abalmos/isoblue-wifi/hardware/udoo-power/udoo-power_bom_.html

Source File | /home/abalmos/isoblue-3/hardware/udoo-power/udoo-power.sch
BoM Date | Mon 23 Sep 2019 11:00:21 AM EDT
Schematic Version
Schematic Date
PCB Variant | default
KiCad Version | Eeschema (5.99.0-111-gae79a2bdc)
Component Groups | 60
Component Count (per PCB) | 81
Fitted Components (per PCB) | 81
Number of PCBs | 1
Total Component Count (for 1 PCBs) | 81
 | Description | Part | References | Value | Footprint | Quantity Per PCB | Datasheet | PartNum | DigiKey | Voltage | Color | DigiKey2 | Datasheet2 | PartNum2 | DNP | Tol | Power
1 | Unpolarized capacitor, small symbol | C_Small | C1 C2 C4 C6 C7 C8 C9 | 0.1uF | C_0603_1608Metric_Pad1.05x0.95mm_HandSolder | 7 | http://www.samsungsem.com/kr/support/product-search/mlcc/CL10B104KB8NNNL.jsp | CL10B104KB8NNNL | 1276-CL10B104KB8NNNLCT-ND | 50V
2 | Unpolarized capacitor, small symbol | C_Small | C10 | 10nF | C_0603_1608Metric_Pad1.05x0.95mm_HandSolder | 1 | http://www.samsungsem.com/kr/support/product-search/mlcc/CL10B103KB8NNNC.jsp | CL10B103KB8NNNC | 1276-1009-1-ND | 50V
3 | Unpolarized capacitor, small symbol | C_Small | C3 | 10uF | C_0603_1608Metric_Pad1.05x0.95mm_HandSolder | 1 | http://www.samsungsem.com/kr/support/product-search/mlcc/CL10A106MQ8NNNC.jsp | CL10A106MQ8NNNC | 1276-1119-1-ND
4 | Unpolarized capacitor, small symbol | C_Small | C5 C12 | 1uF | C_0603_1608Metric_Pad1.05x0.95mm_HandSolder | 2 | https://media.digikey.com/pdf/Data%20Sheets/Samsung%20PDFs/CL10B105MO8NNWC.pdf | CL10B105MO8NNWC CL10A105KB8NNNC | 1276-6524-1-ND 1276-1860-1-ND | 50V
5 | Unpolarized capacitor, small symbol | C_Small | C15 | 2.2u | C_0603_1608Metric_Pad1.05x0.95mm_HandSolder | 1 | http://www.samsungsem.com/kr/support/product-search/mlcc/CL10B225KQ8NFNC.jsp | CL10B225KQ8NFNC | 1276-2017-1-ND
6 | Unpolarized capacitor, small symbol | C_Small | C11 | 220uF | CP_Radial_D10.0mm_P5.00mm | 1 | https://industrial.panasonic.com/cdbs/www-data/pdf/RDF0000/ABA0000C1018.pdf | EEU-FM1H221 | P12397-ND | 50V
7 | Unpolarized capacitor, small symbol | C_Small | C13 C14 C16 | 22uF | C_1812_4532Metric_Pad1.30x3.40mm_HandSolder | 3 | https://product.tdk.com/info/en/catalog/datasheets/mlcc_commercial_general_en.pdf | C4532X7R1E226M250KC | 445-1607-1-ND
8 | Zener diode, small symbol, filled shape | D_Zener_Small_ALT | D10 | 18V | D_SOD-123 | 1 | https://www.taiwansemi.com/products/datasheet/BZT52B2V4%20series_F15.pdf | BZT52B18 | BZT52B18RHGCT-ND
9 | Light emitting diode, small symbol, filled shape | LED_Small_ALT | D1 | ACT. | LED_0805_2012Metric_Pad1.15x1.40mm_HandSolder | 1 | https://katalog.we-online.de/led/datasheet/150080BS75000.pdf | 150080BS75000 | 732-4982-1-ND |  | blue
10 | Light emitting diode, small symbol, filled shape | LED_Small_ALT | D2 | CELL | LED_0805_2012Metric_Pad1.15x1.40mm_HandSolder | 1 | https://katalog.we-online.de/led/datasheet/150080BS75000.pdf | 150080BS75000 | 732-4982-1-ND |  | blue
11 | Light emitting diode, small symbol, filled shape | LED_Small_ALT | D4 | GPS | LED_0805_2012Metric_Pad1.15x1.40mm_HandSolder | 1 | https://katalog.we-online.de/led/datasheet/150080BS75000.pdf | 150080BS75000 | 732-4982-1-ND |  | blue
12 | Light emitting diode, small symbol, filled shape | LED_Small_ALT | D5 | LED1 | LED_0805_2012Metric_Pad1.15x1.40mm_HandSolder | 1 | https://katalog.we-online.de/led/datasheet/150080YS75000.pdf | 150080YS75000 | 732-4987-1-ND |  | yellow
13 | Light emitting diode, small symbol, filled shape | LED_Small_ALT | D6 | LED2 | LED_0805_2012Metric_Pad1.15x1.40mm_HandSolder | 1 | https://katalog.we-online.de/led/datasheet/150080YS75000.pdf | 150080YS75000 | 732-4987-1-ND |  | yellow
14 | Light emitting diode, small symbol, filled shape | LED_Small_ALT | D14 | LED3 | LED_0805_2012Metric_Pad1.15x1.40mm_HandSolder | 1 | https://katalog.we-online.de/led/datasheet/150080RS75000.pdf | 150080RS75000 | 732-4984-1-ND |  | red
15 | Light emitting diode, small symbol, filled shape | LED_Small_ALT | D15 | LED4 | LED_0805_2012Metric_Pad1.15x1.40mm_HandSolder | 1 | https://katalog.we-online.de/led/datasheet/150080RS75000.pdf | 150080RS75000 | 732-4984-1-ND |  | red
16 | Light emitting diode, small symbol, filled shape | LED_Small_ALT | D7 | PC_STATUS | LED_0805_2012Metric_Pad1.15x1.40mm_HandSolder | 1 | https://katalog.we-online.de/led/datasheet/150080RS75000.pdf | 150080RS75000 | 732-4984-1-ND |  | red
17 | Light emitting diode, small symbol, filled shape | LED_Small_ALT | D11 D12 D13 | REG | LED_0805_2012Metric_Pad1.15x1.40mm_HandSolder | 3 | https://katalog.we-online.de/led/datasheet/150080GS75000.pdf | 150080GS75000 | 732-4983-1-ND |  | green
18 | Zener diode, small symbol, filled shape | D_Zener_Small_ALT | D9 | SMBJ17A | D_SMB | 1 | https://www.diodes.com/assets/Datasheets/ds19002.pdf | SMBJ17A-E3/52 | SMBJ17A-E3/52GICT-ND
19 | Zener diode, small symbol, filled shape | D_Zener_Small_ALT | D8 | SMBJ40A | D_SMB | 1 | https://www.diodes.com/assets/Datasheets/ds19002.pdf | SMBJ40A-E3/52 | SMBJ40A-E3/52GICT-ND
20 | Light emitting diode, small symbol, filled shape | LED_Small_ALT | D3 | WIFI | LED_0805_2012Metric_Pad1.15x1.40mm_HandSolder | 1 | https://katalog.we-online.de/led/datasheet/150080BS75000.pdf | 150080BS75000 | 732-4982-1-ND |  | blue
21 |  | KICAD_LOGO | G4 | KICAD_LOGO | KiCad-Logo2_6mm_SilkScreen | 1
22 |  | OATS_LOGO | G1 | OATS_LOGO | OATS_LOGO | 1
23 |  | PURDUE_LOGO | G2 | PURDUE_LOGO | PURDUE_LOGO | 1
24 |  | WHIN_LOGO | G3 | WHIN_LOGO | WHIN_LOGO | 1
25 | Generic connector, single row, 01x02, script generated (kicad-library-utils/schlib/autogen/connector/) | Conn_01x02 | J10 | 12V_B2B | PinHeader_1x02_P2.54mm_Vertical | 1 | https://www.molex.com/pdm_docs/sd/022032021_sd.pdf | 22-03-2021 | WM4000-ND
26 | Generic connector, single row, 01x03, script generated (kicad-library-utils/schlib/autogen/connector/) | Conn_01x03 | J2 | 48V_ISO | TerminalBlock_Phoenix_PT-1,5-3-5.0-H_1x03_P5.00mm_Horizontal | 1 | https://media.digikey.com/pdf/Data%20Sheets/Phoenix%20Contact%20PDFs/1935174.pdf | 1935174 | 277-1578-ND
27 | Generic connector, single row, 01x03, script generated (kicad-library-utils/schlib/autogen/connector/) | Conn_01x03 | J11 | 48V_ISO_B2B | PinHeader_1x03_P2.54mm_Vertical | 1 | https://www.molex.com/pdm_docs/sd/022032031_sd.pdf | 22-03-2031 | WM4001-ND
28 | Generic connector, single row, 01x04, script generated (kicad-library-utils/schlib/autogen/connector/) | Conn_01x04 | J9 | CONSOLE | PinHeader_1x04_P2.54mm_Vertical | 1 | https://katalog.we-online.de/em/datasheet/6130xx11121.pdf | 61300411121 | 732-5317-ND
29 | Generic connector, single row, 01x10, script generated (kicad-library-utils/schlib/autogen/connector/) | Conn_01x10 | J8 | SWD | TC2050-IDC | 1 | https://www.st.com/content/ccc/resource/technical/document/application_note/fd/f4/6b/40/9a/b5/41/a2/DM00112257.pdf/files/DM00112257.pdf/jcr:content/translatio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
30 | Generic connector, double row, 02x08, odd/even pin numbering scheme (row 1 odd numbers, row 2 even numbers), script generated (kicad-library-utils/schlib/autogen/connector/) | Conn_02x08_Odd_Even | J4 J7 | UDOO_CN12 | PinHeader_2x08_P2.54mm_Vertical_SMD | 2 | https://www.te.com/commerce/DocumentDelivery/DDEController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 | 5-146131-3 | A128845-ND
31 | Generic connector, double row, 02x10, odd/even pin numbering scheme (row 1 odd numbers, row 2 even numbers), script generated (kicad-library-utils/schlib/autogen/connector/) | Conn_02x10_Odd_Even | J6 | UDOO_CN13 | PinHeader_2x10_P2.54mm_Vertical_SMD | 1 | https://www.te.com/commerce/DocumentDelivery/DDEController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 | 5-146131-4 | 5-146131-4-ND
32 | Generic connector, double row, 02x06, odd/even pin numbering scheme (row 1 odd numbers, row 2 even numbers), script generated (kicad-library-utils/schlib/autogen/connector/) | Conn_02x06_Odd_Even | J5 | UDOO_CN14 | PinHeader_2x06_P2.54mm_Vertical_SMD | 1 | https://www.te.com/commerce/DocumentDelivery/DDEController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 | 5-146131-2 | 5-146131-2-ND
33 | Generic connector, single row, 01x02, script generated (kicad-library-utils/schlib/autogen/connector/) | Conn_01x02 | J1 J3 | Vin | TerminalBlock_Phoenix_PT-1,5-2-5.0-H_1x02_P5.00mm_Horizontal | 2 | https://media.digikey.com/pdf/Data%20Sheets/Phoenix%20Contact%20PDFs/1935161.pdf | 1935161 | 277-1667-ND
34 | Jumper, 3-pole, pins 1+2 closed/bridged | Jumper_3_Bridged12 | JP1 JP2 | CTRL | PinHeader_1x03_P2.54mm_Vertical | 2 | https://katalog.we-online.de/em/datasheet/6130xx11121.pdf | 61300311121 | 732-5316-ND |  |  | 952-3367-ND | https://cdn.harwin.com/pdfs/M7680-M7683.pdf | M7681-46
35 | Open Hardware logo, small | Logo_Open_Hardware_Small | LOGO1 | Logo_Open_Hardware_Small | OSHW-Logo_7.5x8mm_SilkScreen | 1 | ~
36 | 50V Vds, 0.22A Id, N-Channel MOSFET, SOT-23 | BSS138 | Q8 Q9 | BSS138 | SOT-23 | 2 | https://www.onsemi.com/pub/Collateral/BSS138K-D.pdf | BSS138K | BSS138KCT-ND
37 | Power, Dual N-Channel 60 V, 6.5 m, 68 A | NVMFD5C668NL | Q7 | NVMFD5C668NL | DFN-8-2EP_5x6mm_P1.27mm_EP4.84x5.55mm | 1 | https://www.onsemi.com/pub/Collateral/NVMFD5C668NL-D.PDF | NVMFD5C668NLT1G | NVMFD5C668NLT1GOSCT-ND
38 | Resistor, small US symbol | R_Small_US | R18 | 0 | R_0603_1608Metric_Pad1.05x0.95mm_HandSolder | 1 |  | DNP | DNP |  |  |  |  |  | DNP
39 | Resistor, small US symbol | R_Small_US | R25 | 100 | R_0603_1608Metric_Pad1.05x0.95mm_HandSolder | 1 | https://www.te.com/commerce/DocumentDelivery/DDEController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 | CRGP0603F100R | A130404CT-ND
40 | Resistor, small US symbol | R_Small_US | R21 | 100k | R_0603_1608Metric_Pad1.05x0.95mm_HandSolder | 1 | https://www.te.com/commerce/DocumentDelivery/DDEController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 | CRGP0603F100K | A130440CT-ND
41 | Resistor, small US symbol | R_Small_US | R15 R16 | 10k | R_0603_1608Metric_Pad1.05x0.95mm_HandSolder | 2 | https://www.te.com/commerce/DocumentDelivery/DDEController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 | CRGH0603J10K | A126394CT-ND
42 | Resistor, small US symbol | R_Small_US | R24 | 12.4k | R_0603_1608Metric_Pad1.05x0.95mm_HandSolder | 1 | http://www.yageo.com/documents/recent/PYu-RC_Group_51_RoHS_L_10.pdf | RC0603FR-0712K4L | 311-12.4KHRCT-ND |  |  |  |  |  |  | 1%
43 | Resistor, small US symbol | R_Small_US | R30 | 2.4k | R_0603_1608Metric_Pad1.05x0.95mm_HandSolder | 1 | https://www.rohm.com/datasheet/SDR03EZPF/sdr-e | RC0805FR-072K4L | 311-2.40KCRCT-ND
44 | Resistor, small US symbol | R_Small_US | R17 | 20 | R_0603_1608Metric_Pad1.05x0.95mm_HandSolder | 1 | https://www.rohm.com/datasheet/ESR01MZPF/esr-e | ESR03EZPJ200 | RHM20DCT-ND
45 | Resistor, small US symbol | R_Small_US | R26 R27 | 200k | R_0603_1608Metric_Pad1.05x0.95mm_HandSolder | 2 | https://www.rohm.com/datasheet/SDR03EZPF/sdr-e | SDR03EZPF2003 | 511-1705-1-ND
46 | Resistor, small US symbol | R_Small_US | R20 | 27k | R_0603_1608Metric_Pad1.05x0.95mm_HandSolder | 1 | https://www.te.com/commerce/DocumentDelivery/DDEController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 | CRGP0603F27K | A130433CT-ND
47 | Resistor, small US symbol | R_Small_US | R23 | 28k | R_0603_1608Metric_Pad1.05x0.95mm_HandSolder | 1 | http://www.yageo.com/documents/recent/PYu-RC_Group_51_RoHS_L_10.pdf | RC0603FR-0728KL | 311-28.0KHRCT-ND |  |  |  |  |  |  | 1%
48 | Resistor, small US symbol | R_Small_US | R22 | 294k | R_0603_1608Metric_Pad1.05x0.95mm_HandSolder | 1 | http://www.yageo.com/documents/recent/PYu-RC_Group_51_RoHS_L_10.pdf | RC0603FR-07294KL | 311-294KHRCT-ND |  |  |  |  |  |  | 1%
49 | Resistor, small US symbol | R_Small_US | R1 R5 R6 R28 R29 | 4.7k | R_0603_1608Metric_Pad1.05x0.95mm_HandSolder | 5 | https://www.te.com/commerce/DocumentDelivery/DDEController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 | CRGH0603J4K7 SDR03EZPF2401 | A126410CT-ND 511-1710-1-ND |  |  |  |  |  |  |  | 1/8
50 | Resistor, small US symbol | R_Small_US | R19 | 470k | R_0603_1608Metric_Pad1.05x0.95mm_HandSolder | 1 | https://www.te.com/commerce/DocumentDelivery/DDEController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 | CRGP0603F470K | A130448CT-ND
51 | Switch, single pole double throw | SW_SPDT | SW3 | ON/OFF | ATE1D-2M3-10-Z | 1 | https://www.nidec-copal-electronics.com/e/catalog/switch/ate.pdf | ATE1D-2M3-10-Z | 563-1157-ND
52 | Push button switch, generic, two pins | SW_Push | SW1 | PWR | SW_SPST_TL3342 | 1 | http://spec_sheets.e-switch.com/specs/P010590.pdf | TL3342F260QG | EG5470CT-ND |  |  | EG2531CT-ND | http://spec_sheets.e-switch.com/specs/P010632.pdf | TL3342F160QG/TR
53 | Push button switch, generic, two pins | SW_Push | SW2 | RESET | SW_SPST_TL3342 | 1 | http://spec_sheets.e-switch.com/specs/P010590.pdf | TL3342F260QG | EG5470CT-ND |  |  | EG2531CT-ND | http://spec_sheets.e-switch.com/specs/P010632.pdf | TL3342F160QG/TR
54 | Load-Dump/Reverse-Voltage Protection Circuits | MAX16126 | U3 | MAX16126 | TQFN-12-EP_3x3mm_P0.5mm_EP1.23x1.23mm | 1 | https://www.mouser.com/datasheet/2/256/MAX16126-MAX16127-1225684.pdf | MAX16126TCA+T | MAX16126TCA+TCT-ND
55 | High Input Voltage, Low IQ μCap LDO Regulator | MIC5233 | U6 | MIC5233 | SOT-23-5_HandSoldering | 1 | http://ww1.microchip.com/downloads/en/DeviceDoc/MIC5233-Data-Sheet-DS20006033D.pdf | MIC5233-1.8YM5-TR | 576-2775-1-ND
56 | Isolated Module DC DC Converter 1 Output 12V 2.5A 9V - 36V Input | PDQ30-Q24-S12-D | U5 | PDQ30-Q24-S12-D | 1x1_DC_DC_MODULE | 1 | https://www.cui.com/product/resource/digikeypdf/pdq30-d.pdf | PDQ30-Q24-S12-D | 102-3892-ND
57 | Isolated Module DC DC Converter 2 Output 24V -24V 417mA, 417mA 9V - 36V Input | PDQE20-Q24-D24-D | U4 | PDQE20-Q24-D24-D | 1x1_DC_DC_MODULE | 1 | https://www.cui.com/product/resource/digikeypdf/pdqe20-d.pdf | PDQE20-Q24-D24-D | 102-6353-ND
58 | ARM Cortex-M0+ MCU, 16KB flash, 2KB RAM, 32MHz, 1.65-3.6V, 16 GPIO, TSSOP-20 | STM32L011F4Px | U1 | STM32L011F4Px | TSSOP-20_4.4x6.5mm_P0.65mm | 1 | http://www.st.com/st-web-ui/static/active/en/resource/technical/document/datasheet/DM00206508.pdf | STM32L011F4P6 | 497-17477-ND
59 | 8-Channel, 8-Bit Fm+ I2C-Bus Constant-Current LED Sink Driver, TSSOP-20 | TLC59108xPW | U7 | TLC59108xPW | TSSOP-20_4.4x6.5mm_P0.65mm | 1 | https://www.ti.com/lit/ds/symlink/tlc59108.pdf
60 | General Purpose Amplifier 1 Circuit Rail-to-Rail SOT-23-5 | TLV379 | U2 | TLV379 | SOT-23-5_HandSoldering | 1 | http://www.ti.com/lit/ds/symlink/tlv379.pdf | TLV379IDBVT | 296-44229-1-ND
