abalmos/isoblue-wifi/hardware/udoo-power/step/ATE1D-2M3-10-Z.stp

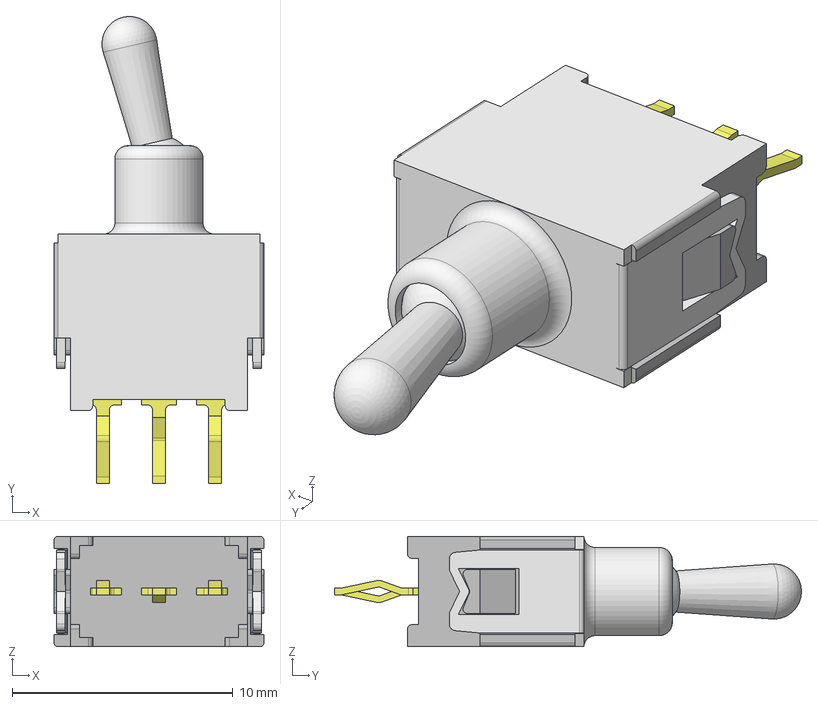
[picture p1: CAD file, 2020-02-06]
hardware/udoo-power/step/ATE1D-2M3-10-Z.stp
9.50 x 21.1 x 5.00 mm
_2001A1_(ATE)
_1001A-1
_1001A-2
_3001A-329
_3001A-229
_3001A-29
