abalmos/isoblue-wifi/hardware/udoo-power/step/1x1-dc-dc-module.step

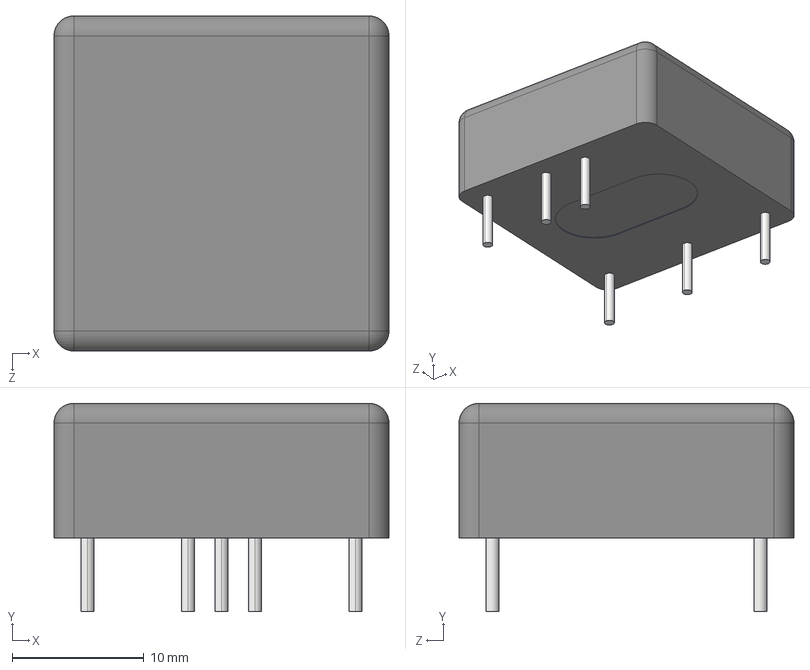
[picture p2: CAD file, 2020-02-06]
hardware/udoo-power/step/1x1-dc-dc-module.step
25.4 x 15.8 x 25.4 mm
