abalmos/isoblue-wifi/hardware/udoo-power/step/DFN8-5X6-DUAL.step

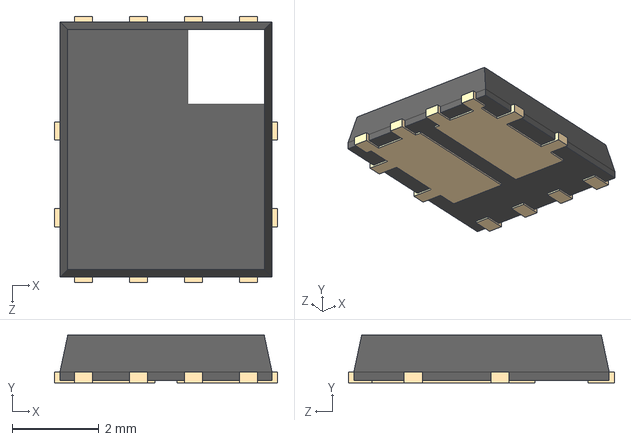
[picture p3: CAD file, 2020-02-06]
hardware/udoo-power/step/DFN8-5X6-DUAL.step
5.15 x 1.10 x 6.15 mm
