abalmos/isoblue-wifi/hardware/udoo-power/step/21-0136I_T1233-4.step

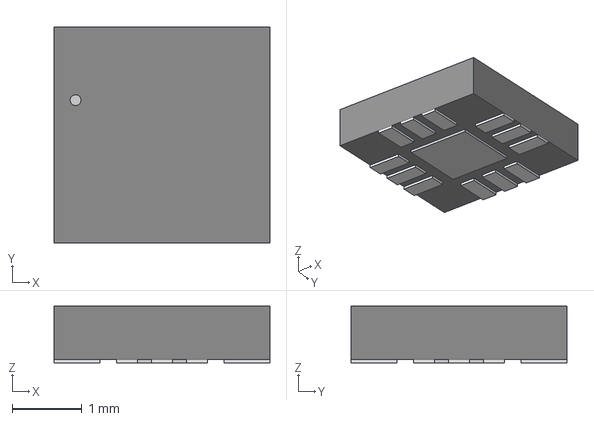
[picture p4: CAD file, 2020-02-06]
hardware/udoo-power/step/21-0136I_T1233-4.step
3.10 x 3.10 x 0.815 mm
