abalmos/isoblue-wifi/hardware/udoo-power/step/1935161--3DModel-STEP-56544.STEP

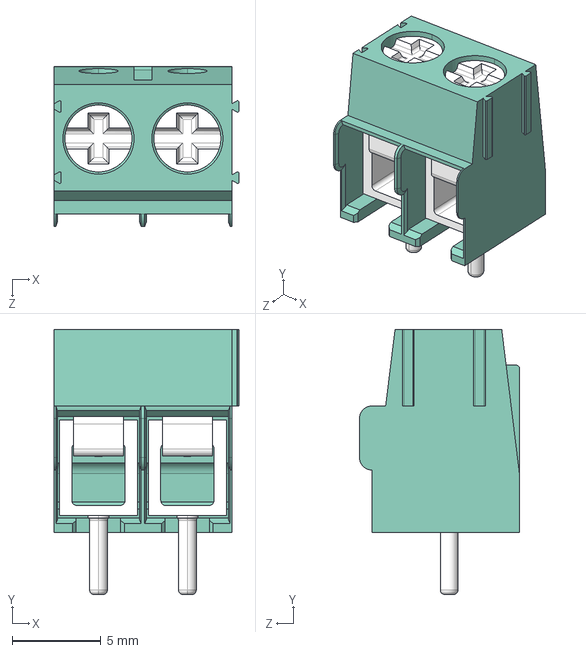
[picture p5: CAD file, 2020-02-06]
hardware/udoo-power/step/1935161--3DModel-STEP-56544.STEP
10.4 x 14.9 x 9.00 mm
