abalmos/isoblue-wifi/hardware/udoo-power/prints-2019-09-23/udoo-power.pdf

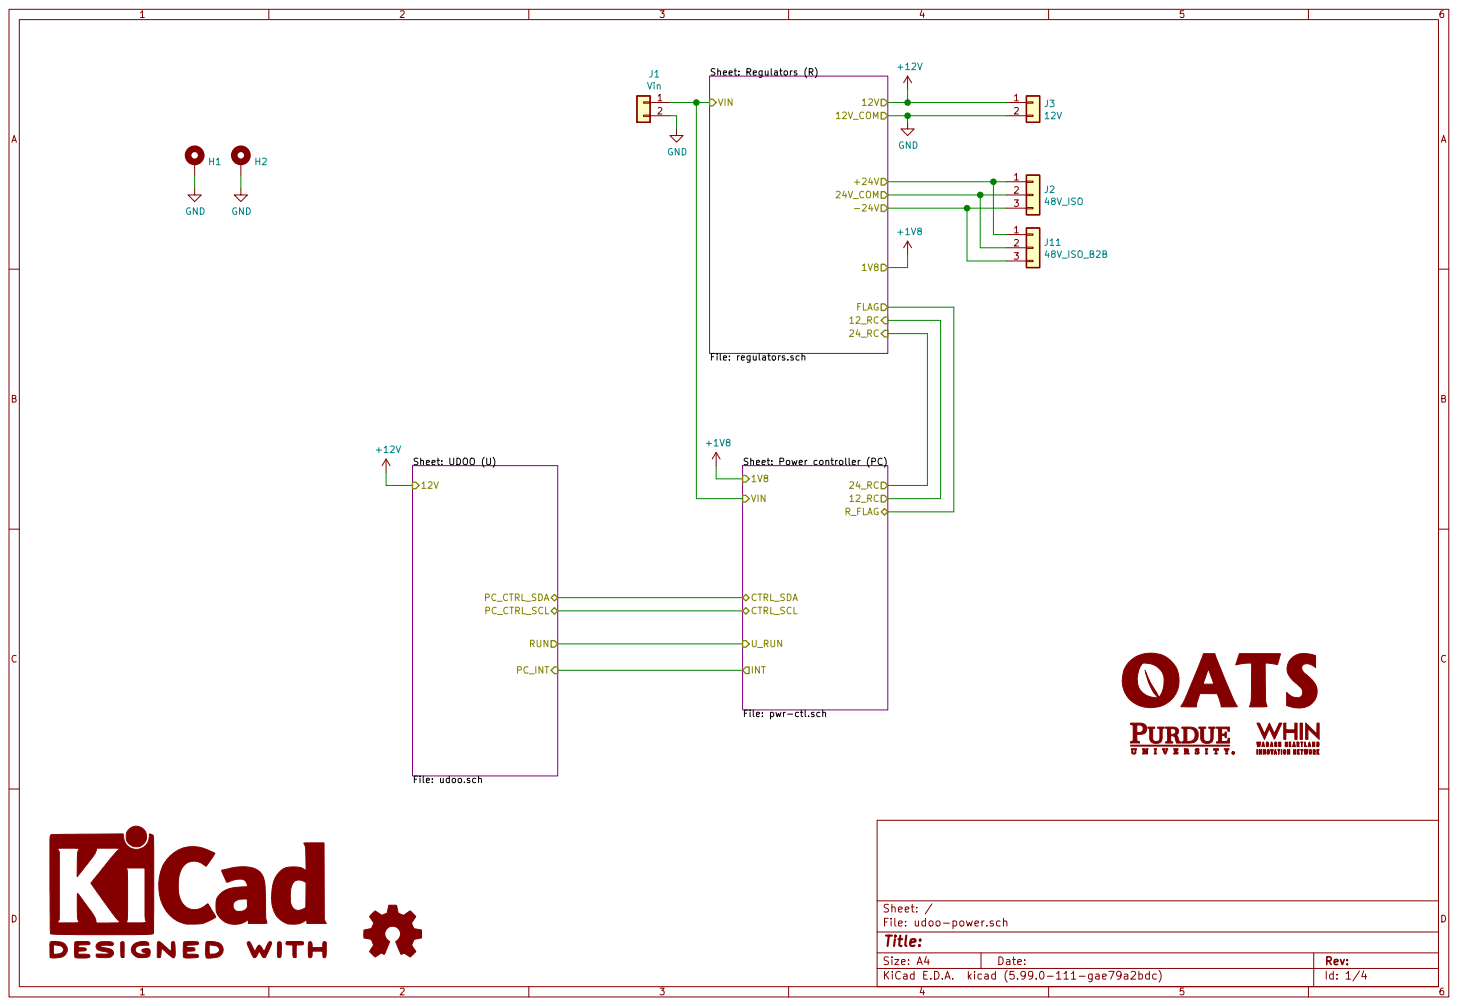
[picture p6: page 1]

+1V8 +12V GND
File: regulators.sch VIN

Sheet: UDOO (U) File: udoo.sch

File: pwr-ctl.sch

File: udoo-power.sch Sheet: /
Id: 1/4 Title:

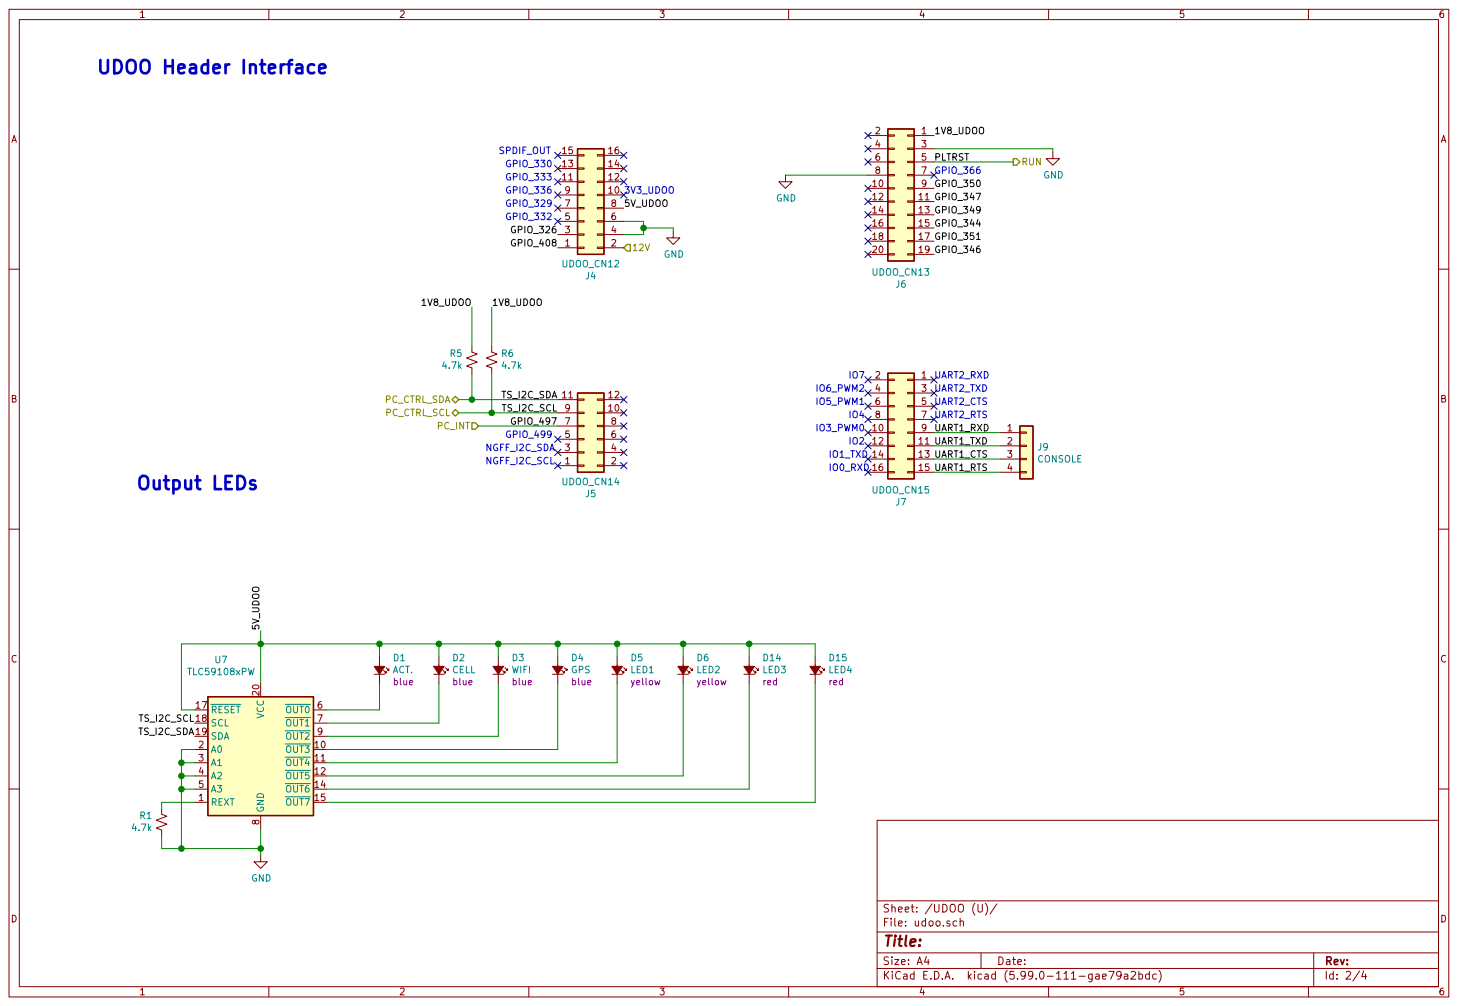
[picture p7: page 2]

red D3 WIFI blue D2 CELL

Id: 2/4 Title: File: udoo.sch Sheet: /UDOO (U)/

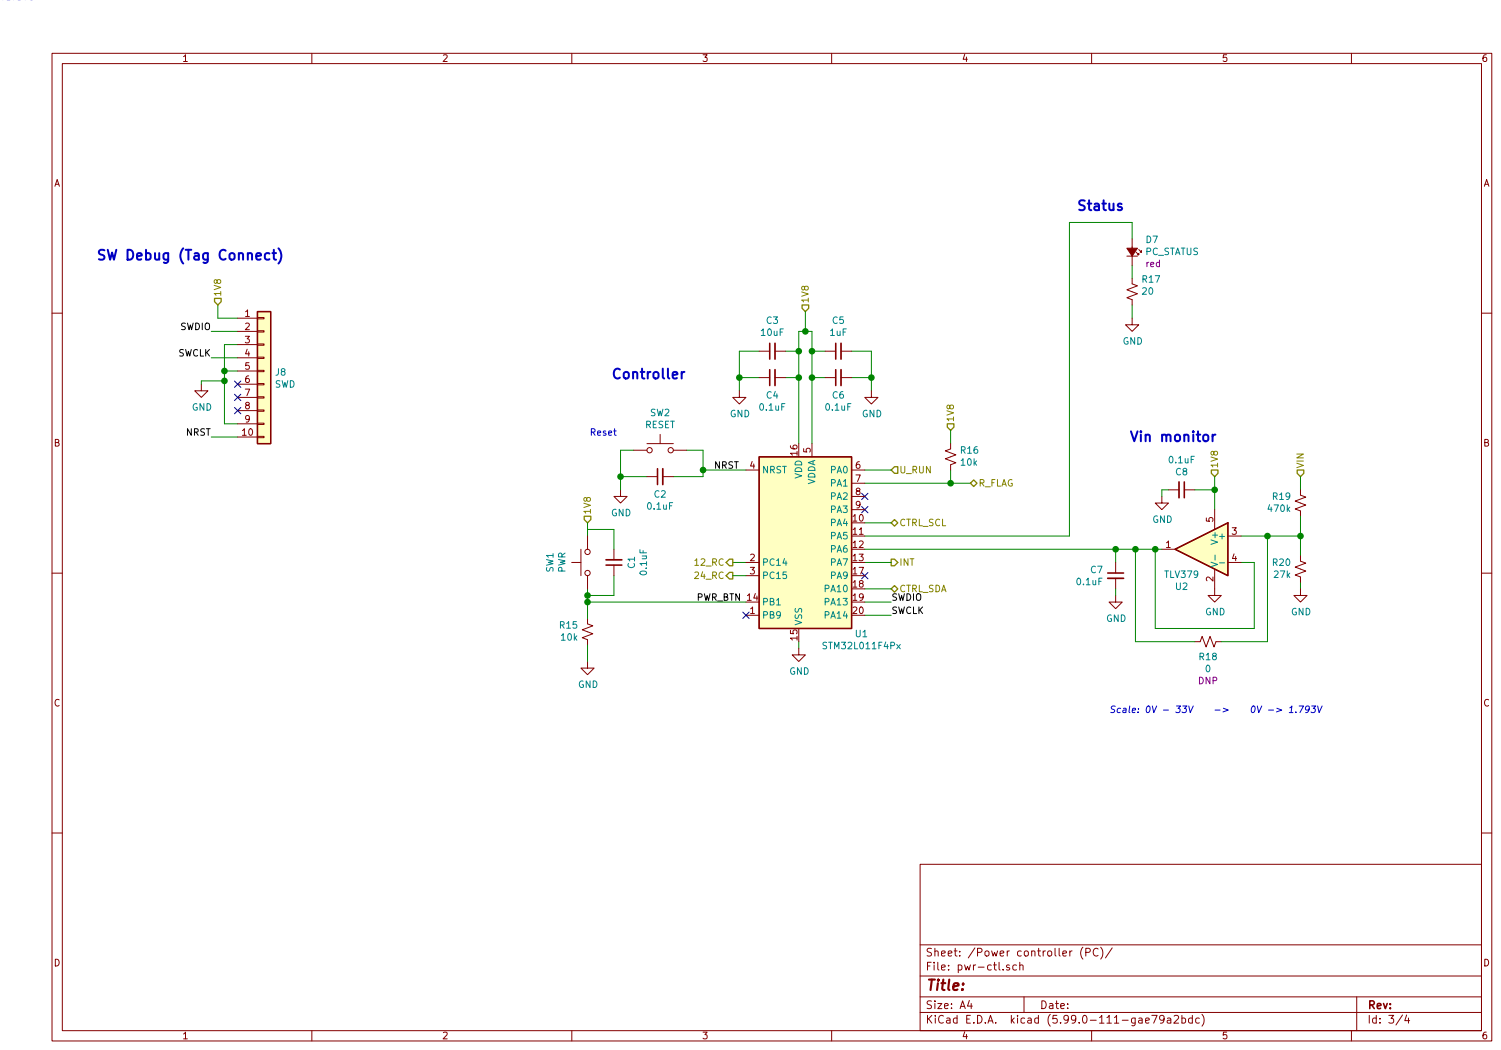
[picture p8: page 3]

SW Debug (Tag Connect) 1V8 NRST SWCLK

SWCLK GND GND GND

Sheet: /Power controller (PC)/
File: pwr-ctl.sch
Id: 3/4 Title:

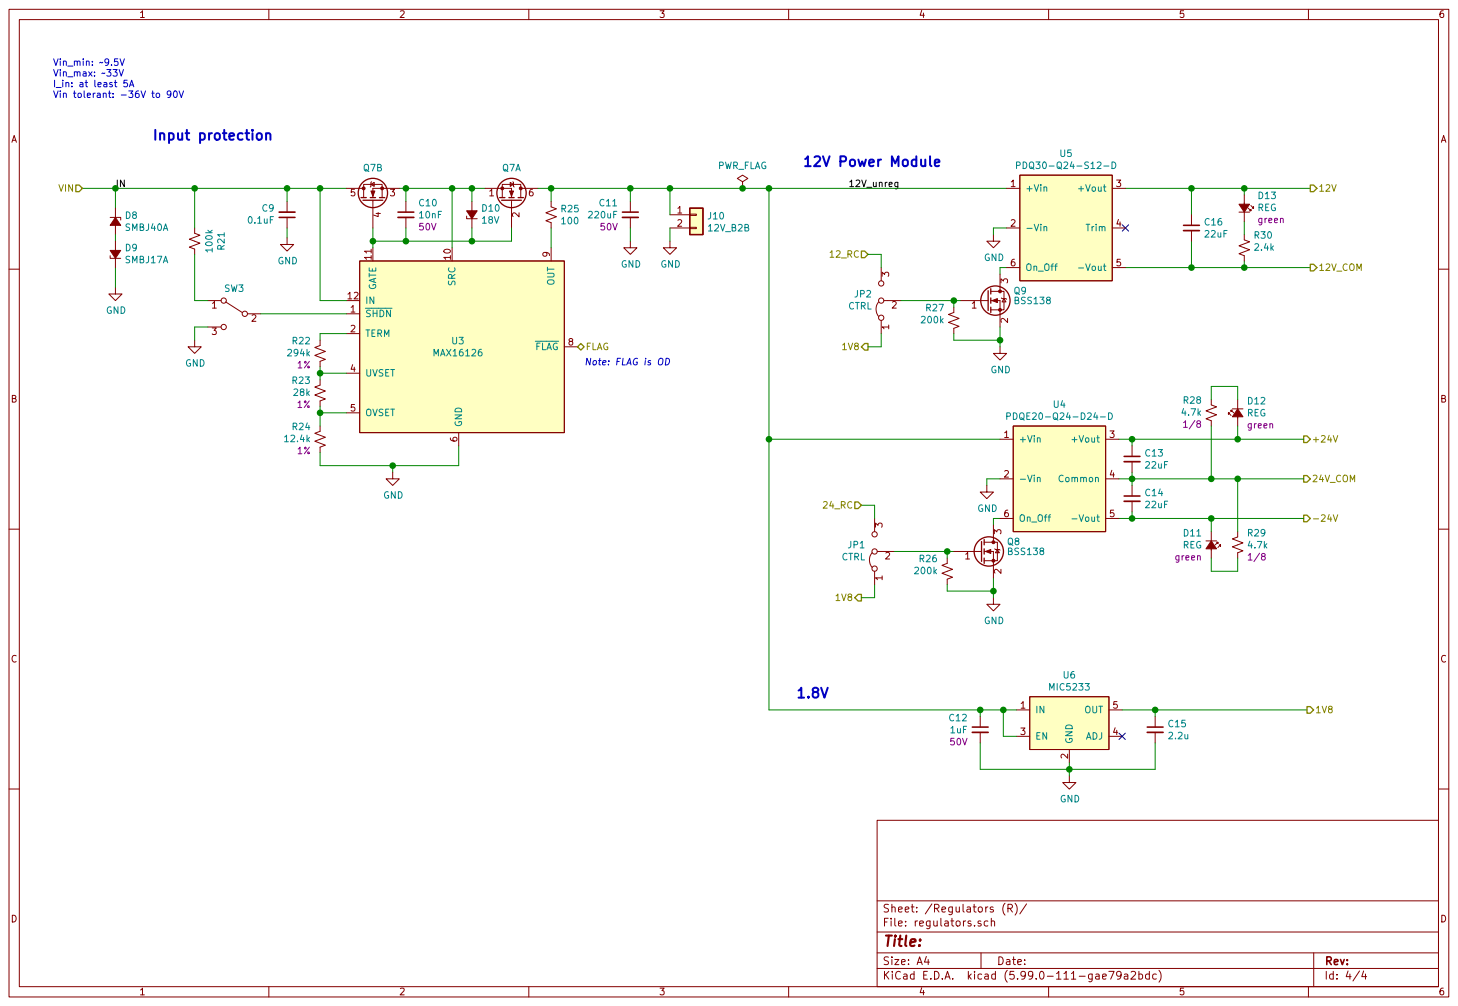
[picture p9: page 4]

2 EN 3 ADJ 4 OUT 5 U6 MIC5233 GND
