abalmos/isoblue-wifi/hardware/udoo-power/prints-2019-09-23/layout.pdf

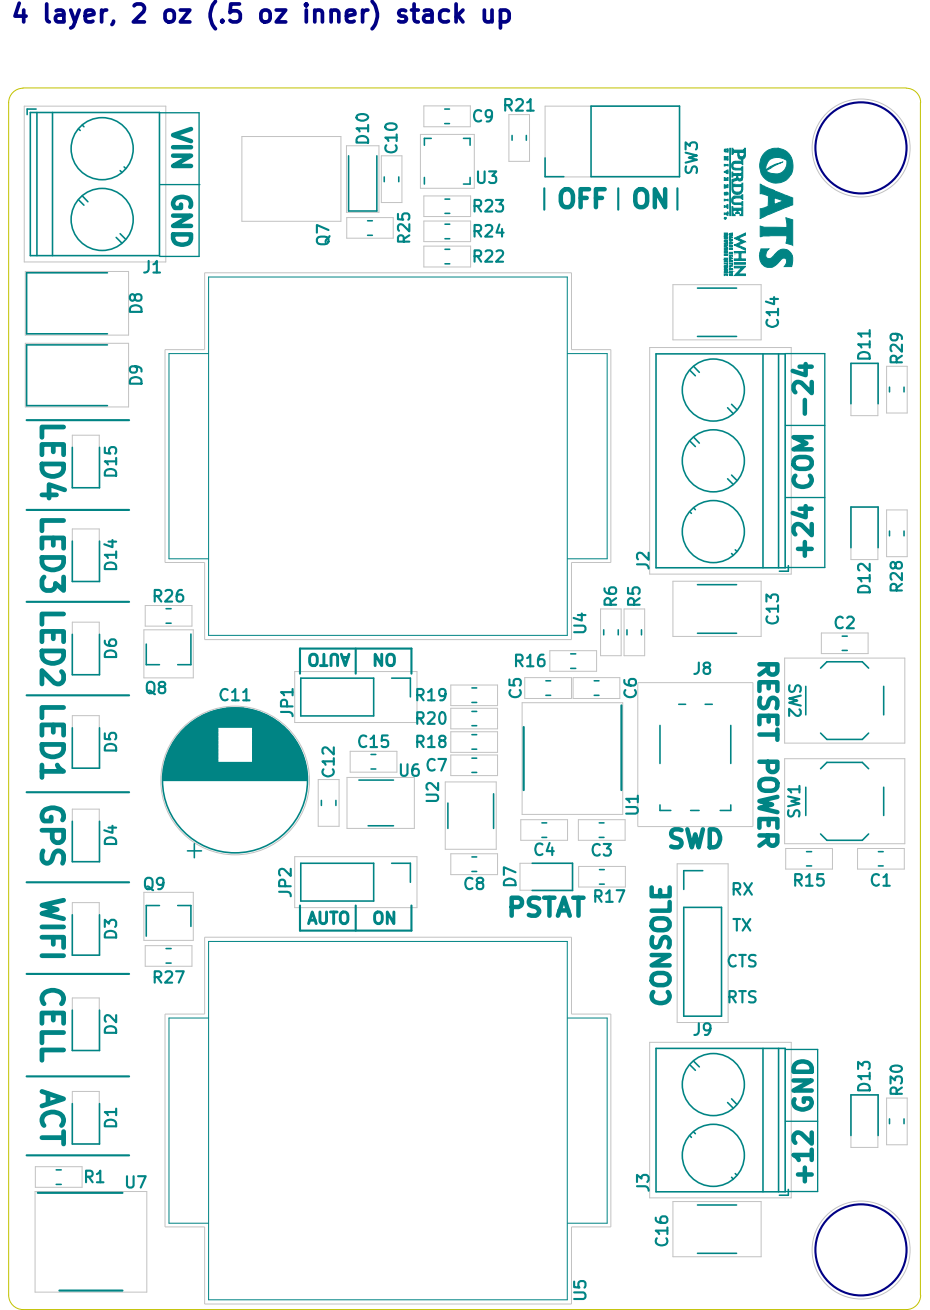
[picture p10: page 1]
