abalmos/isoblue-wifi/hardware/udoo-power/udoo-power.kicad_pcb

## KiCad design hardware/udoo-power/udoo-power.kicad_pcb (2020-02-06)

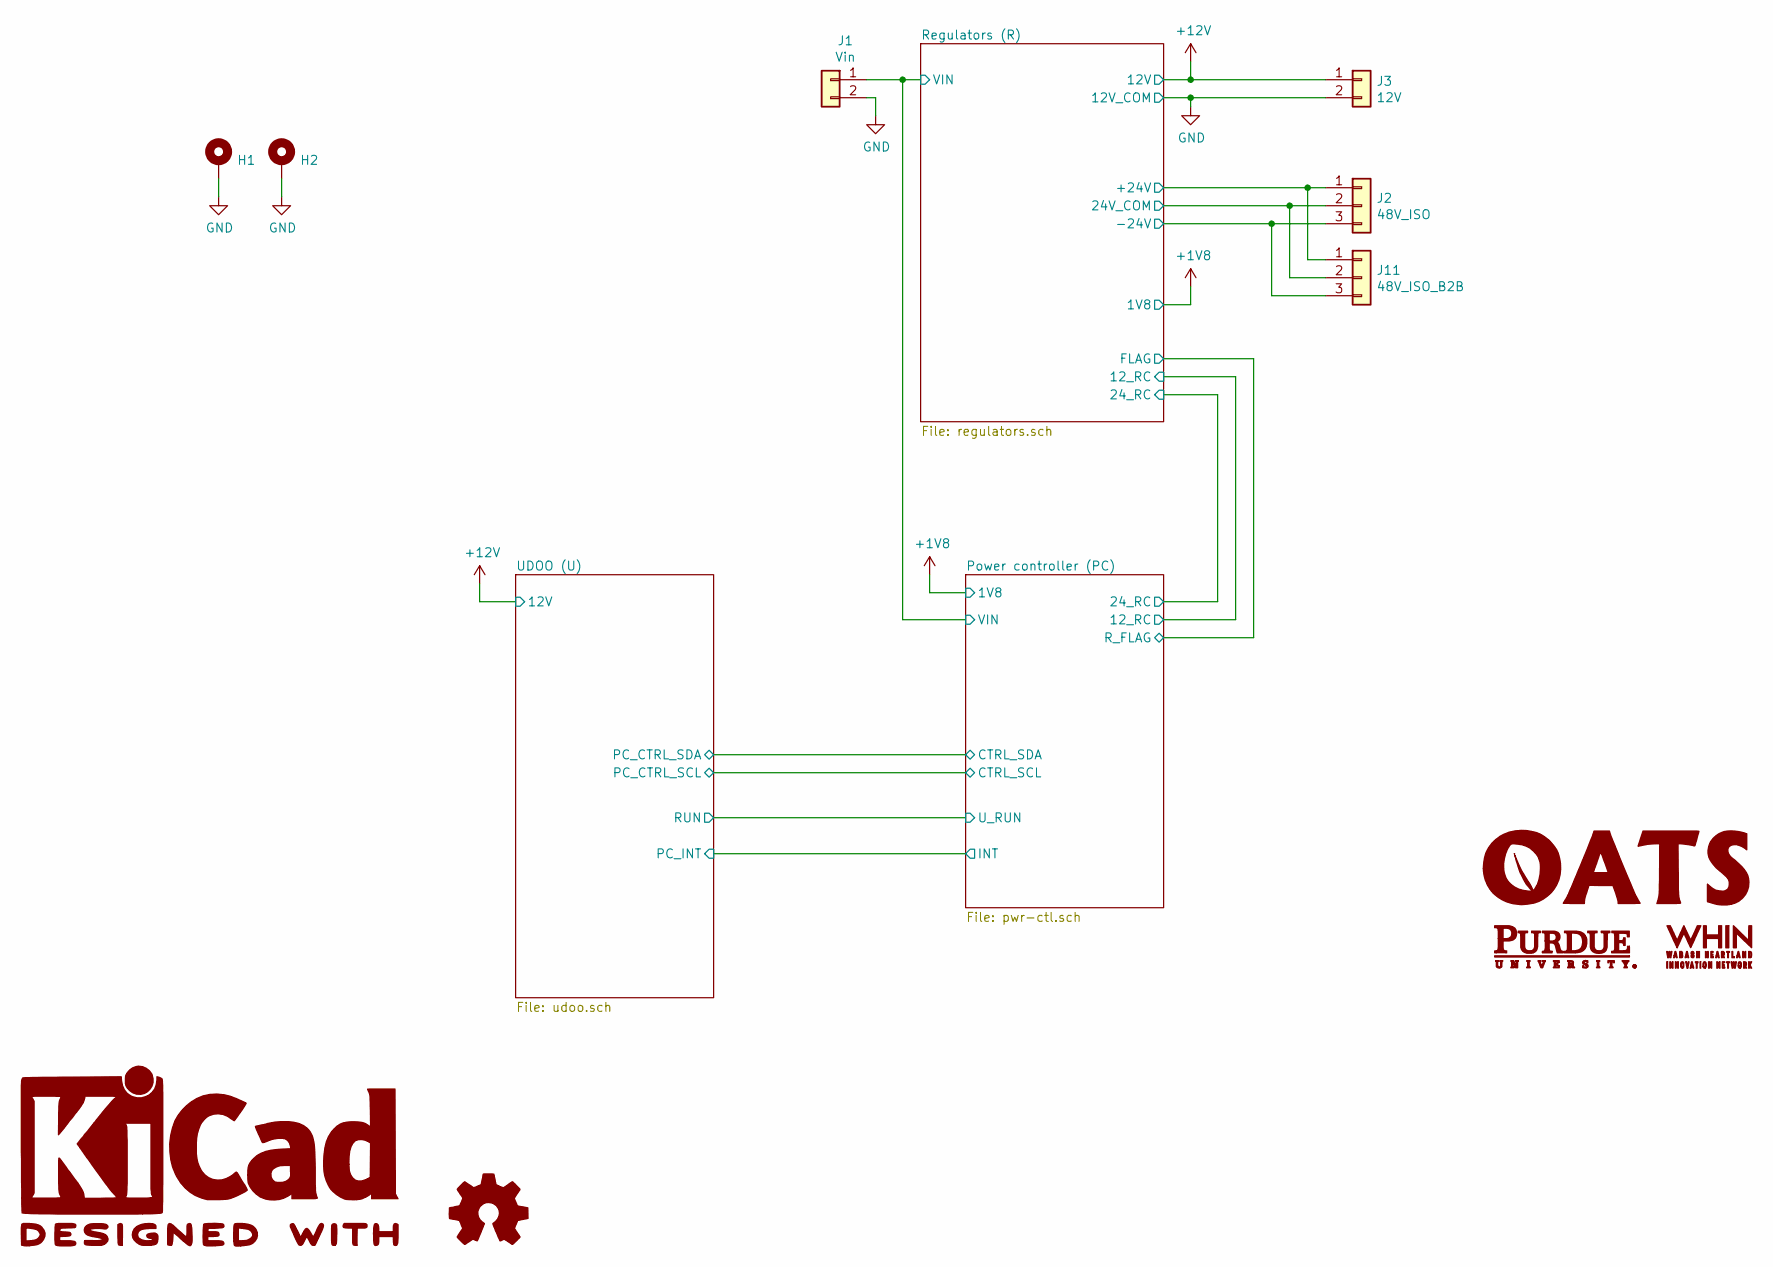
[picture p11: schematic udoo-power.sch]

Parts:
G1: OATS_LOGO
G2: PURDUE_LOGO
G3: WHIN_LOGO
G4: KICAD_LOGO; KiCad-Logo2_6mm_SilkScreen
H1, H2: MountingHole_Pad; MountingHole_3.2mm_M3_Pad_Via
J1: Vin; TerminalBlock_Phoenix_PT-1,5-2-5.0-H_1x02_P5.00mm_Horizontal; PartNum 1935161; DigiKey 277-1667-ND
J2: 48V_ISO; TerminalBlock_Phoenix_PT-1,5-3-5.0-H_1x03_P5.00mm_Horizontal; PartNum 1935174; DigiKey 277-1578-ND
J3: 12V; TerminalBlock_Phoenix_PT-1,5-2-5.0-H_1x02_P5.00mm_Horizontal; PartNum 1935161; DigiKey 277-1667-ND
J11: 48V_ISO_B2B; PinHeader_1x03_P2.54mm_Vertical; PartNum 22-03-2031; DigiKey WM4001-ND
LOGO1: Logo_Open_Hardware_Small; OSHW-Logo_7.5x8mm_SilkScreen

Connections:
+12V: J3.1; also elsewhere on the board
/24V_COM: J2.2, J11.2; also elsewhere on the board
/+24V: J2.1, J11.1; also elsewhere on the board
/-24V: J2.3, J11.3; also elsewhere on the board
/VIN: J1.1; also elsewhere on the board
GND: H1.1, H2.1, J1.2, J3.2; also elsewhere on the board

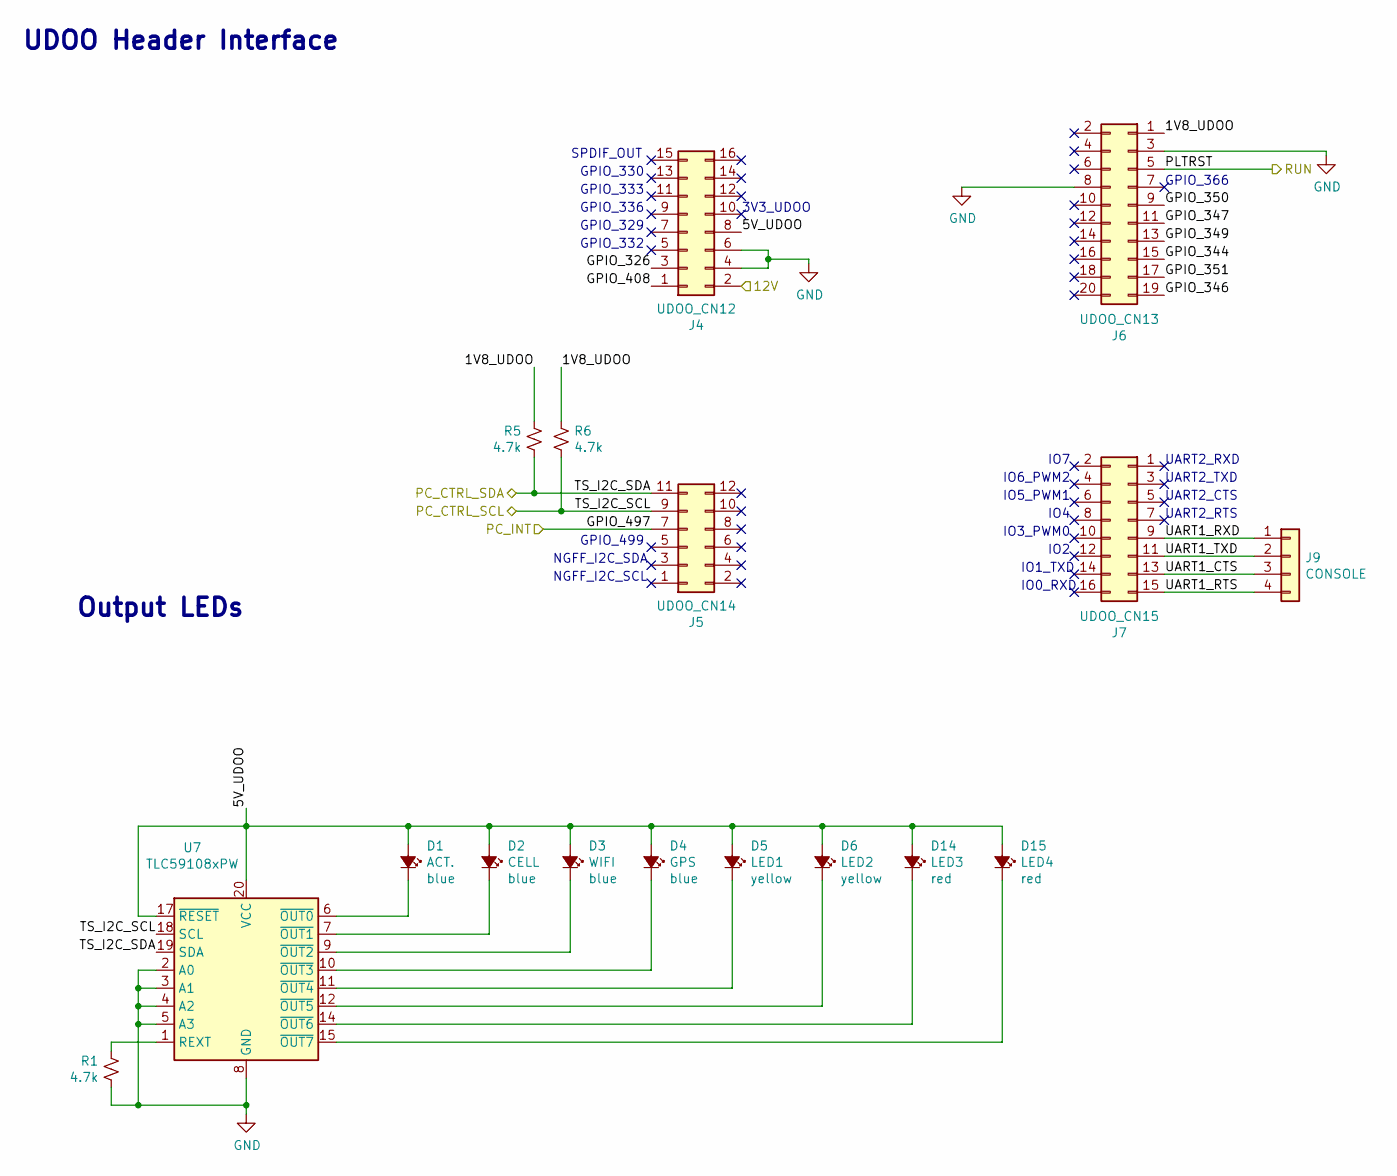
[picture p12: schematic udoo.sch]

Parts:
D1: ACT.; LED_0805_2012Metric_Pad1.15x1.40mm_HandSolder; PartNum 150080BS75000; DigiKey 732-4982-1-ND
D2: CELL; LED_0805_2012Metric_Pad1.15x1.40mm_HandSolder; PartNum 150080BS75000; DigiKey 732-4982-1-ND
D3: WIFI; LED_0805_2012Metric_Pad1.15x1.40mm_HandSolder; PartNum 150080BS75000; DigiKey 732-4982-1-ND
D4: GPS; LED_0805_2012Metric_Pad1.15x1.40mm_HandSolder; PartNum 150080BS75000; DigiKey 732-4982-1-ND
D5: LED1; LED_0805_2012Metric_Pad1.15x1.40mm_HandSolder; PartNum 150080YS75000; DigiKey 732-4987-1-ND
D6: LED2; LED_0805_2012Metric_Pad1.15x1.40mm_HandSolder; PartNum 150080YS75000; DigiKey 732-4987-1-ND
D14: LED3; LED_0805_2012Metric_Pad1.15x1.40mm_HandSolder; PartNum 150080RS75000; DigiKey 732-4984-1-ND
D15: LED4; LED_0805_2012Metric_Pad1.15x1.40mm_HandSolder; PartNum 150080RS75000; DigiKey 732-4984-1-ND
J4: UDOO_CN12; PinHeader_2x08_P2.54mm_Vertical_SMD; PartNum TSM-108-02-L-DV; DigiKey SAM10297-ND
J5: UDOO_CN14; PinHeader_2x06_P2.54mm_Vertical_SMD; PartNum TSM-106-02-L-DV; DigiKey SAM12243-ND
J6: UDOO_CN13; PinHeader_2x10_P2.54mm_Vertical_SMD; PartNum TSM-110-02-L-DV; DigiKey SAM15911-ND
J7: UDOO_CN15; PinHeader_2x08_P2.54mm_Vertical_SMD; PartNum TSM-108-02-L-DV; DigiKey SAM10297-ND
J9: CONSOLE; PinHeader_1x04_P2.54mm_Vertical; PartNum 61300411121; DigiKey 732-5317-ND
R1, R5, R6: 4.7k; R_0603_1608Metric_Pad1.05x0.95mm_HandSolder; PartNum CRGH0603J4K7; DigiKey A126410CT-ND
U7: TLC59108xPW; TSSOP-20_4.4x6.5mm_P0.65mm; PartNum tlc59108; DigiKey 296-25340-1-ND

Connections:
+12V: J4.2; also elsewhere on the board
/CTRL_SCL: J5.9, R6.1, U7.18 (SCL); also elsewhere on the board
/CTRL_SDA: J5.11, R5.1, U7.19 (SDA); also elsewhere on the board
/INT: J5.7; also elsewhere on the board
/RUN: J6.5; also elsewhere on the board
/UDOO (U)/1V8_UDOO: J6.1, R5.2, R6.2
/UDOO (U)/5V_UDOO: D1.2 (A), D2.2 (A), D3.2 (A), D4.2 (A), D5.2 (A), D6.2 (A), D14.2 (A), D15.2 (A), J4.8, U7.17 (~RESET), U7.20 (VCC)
/UDOO (U)/GPIO_326: J4.3
/UDOO (U)/GPIO_344: J6.15
/UDOO (U)/GPIO_346: J6.19
/UDOO (U)/GPIO_347: J6.11
/UDOO (U)/GPIO_349: J6.13
/UDOO (U)/GPIO_350: J6.9
/UDOO (U)/GPIO_351: J6.17
/UDOO (U)/GPIO_408: J4.1
/UDOO (U)/UART1_CTS: J7.13, J9.3
/UDOO (U)/UART1_RTS: J7.15, J9.4
/UDOO (U)/UART1_RXD: J7.9, J9.1
/UDOO (U)/UART1_TXD: J7.11, J9.2
GND: J4.4, J4.6, J6.3, J6.8, R1.1, U7.2 (A0), U7.3 (A1), U7.4 (A2), U7.5 (A3), U7.8 (GND), U7.13 (GND), U7.16 (GND); also elsewhere on the board
unnamed: D1.1 (K), U7.6 (~OUT0)
unnamed: D2.1 (K), U7.7 (~OUT1)
unnamed: D3.1 (K), U7.9 (~OUT2)
unnamed: D4.1 (K), U7.10 (~OUT3)
unnamed: D5.1 (K), U7.11 (~OUT4)
unnamed: D6.1 (K), U7.12 (~OUT5)
unnamed: D14.1 (K), U7.14 (~OUT6)
unnamed: D15.1 (K), U7.15 (~OUT7)
unnamed: R1.2, U7.1 (REXT)

Notes on the sheet:
UDOO Header Interface
Output LEDs
UART2_TXD
UART2_RXD
UART2_RTS
UART2_CTS
IO0_RXD
IO1_TXD
IO2
IO3_PWM0
IO4
IO5_PWM1
IO6_PWM2
IO7
GPIO_366
3V3_UDOO
SPDIF_OUT
GPIO_330
GPIO_333
GPIO_336
GPIO_329
GPIO_332
GPIO_499
NGFF_I2C_SDA
NGFF_I2C_SCL

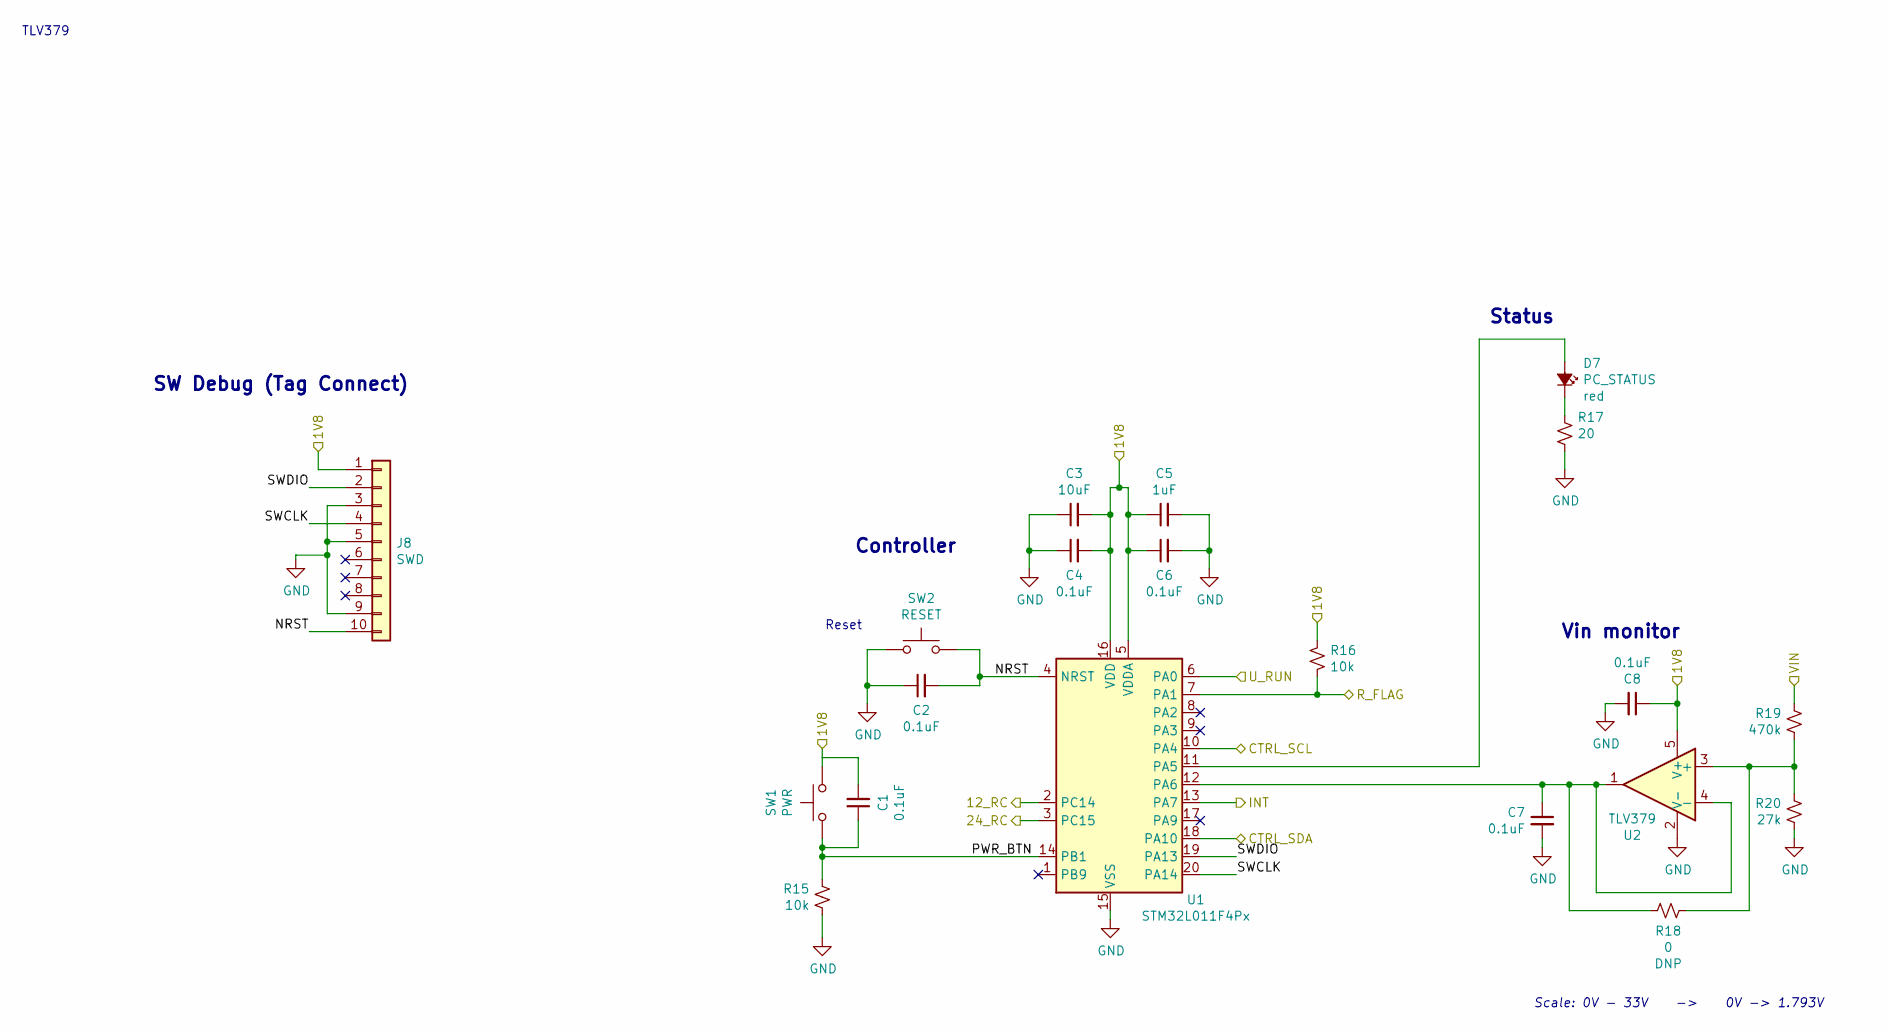
[picture p13: schematic pwr-ctl.sch]

Parts:
C1, C2, C4, C6, C7, C8: 0.1uF; C_0603_1608Metric_Pad1.05x0.95mm_HandSolder; PartNum CL10B104KB8NNNL; DigiKey 1276-CL10B104KB8NNNLCT-ND
C3: 10uF; C_0603_1608Metric_Pad1.05x0.95mm_HandSolder; PartNum CL10A106MQ8NNNC; DigiKey 1276-1119-1-ND
C5: 1uF; C_0603_1608Metric_Pad1.05x0.95mm_HandSolder; PartNum CL10B105MO8NNWC; DigiKey 1276-6524-1-ND
D7: PC_STATUS; LED_0805_2012Metric_Pad1.15x1.40mm_HandSolder; PartNum 150080RS75000; DigiKey 732-4984-1-ND
J8: SWD; TC2050-IDC
R15, R16: 10k; R_0603_1608Metric_Pad1.05x0.95mm_HandSolder; PartNum CRGH0603J10K; DigiKey A126394CT-ND
R17: 20; R_0603_1608Metric_Pad1.05x0.95mm_HandSolder; PartNum ESR03EZPJ200; DigiKey RHM20DCT-ND
R18: 0; R_0603_1608Metric_Pad1.05x0.95mm_HandSolder; PartNum DNP; DigiKey DNP
R19: 470k; R_0603_1608Metric_Pad1.05x0.95mm_HandSolder; PartNum CRGP0603F470K; DigiKey A130448CT-ND
R20: 27k; R_0603_1608Metric_Pad1.05x0.95mm_HandSolder; PartNum CRGP0603F27K; DigiKey A130433CT-ND
SW1: PWR; SW_SPST_TL3342; PartNum TL3342F260QG; DigiKey EG5470CT-ND
SW2: RESET; SW_SPST_TL3342; PartNum TL3342F260QG; DigiKey EG5470CT-ND
U1: STM32L011F4Px; TSSOP-20_4.4x6.5mm_P0.65mm; PartNum STM32L011F4P6; DigiKey 497-17477-ND
U2: TLV379; SOT-23-5_HandSoldering; PartNum TLV379IDBVT; DigiKey 296-44229-1-ND

Connections:
+1V8: C1.2, C3.2, C4.2, C5.1, C6.1, C8.1, J8.1, R16.2, SW1.2, U1.5 (VDDA), U1.16 (VDD), U2.5 (V+); also elsewhere on the board
/12_RC: U1.2 (PC14); also elsewhere on the board
/24_RC: U1.3 (PC15); also elsewhere on the board
/CTRL_SCL: U1.10 (PA4); also elsewhere on the board
/CTRL_SDA: U1.18 (PA10); also elsewhere on the board
/FLAG: R16.1, U1.7 (PA1); also elsewhere on the board
/INT: U1.13 (PA7); also elsewhere on the board
/Power controller (PC)/NRST: C2.2, J8.10, SW2.2, U1.4 (NRST)
/Power controller (PC)/PWR_BTN: C1.1, R15.2, SW1.1, U1.14 (PB1)
/Power controller (PC)/SWCLK: J8.4, U1.20 (PA14)
/Power controller (PC)/SWDIO: J8.2, U1.19 (PA13)
/RUN: U1.6 (PA0); also elsewhere on the board
/VIN: R19.2; also elsewhere on the board
GND: C2.1, C3.1, C4.1, C5.2, C6.2, C7.2, C8.2, J8.3, J8.5, J8.9, R15.1, R17.1, R20.1, SW2.1, U1.15 (VSS), U2.2 (V-); also elsewhere on the board
unnamed: C7.1, R18.2, U1.12 (PA6), U2.1, U2.4 (-)
unnamed: D7.1 (K), R17.2
unnamed: D7.2 (A), U1.11 (PA5)
unnamed: R18.1, R19.1, R20.2, U2.3 (+)

Notes on the sheet:
SW Debug (Tag Connect)
Controller
TLV379
Status
Reset
Scale: 0V - 33V -> 0V -> 1.793V
Vin monitor

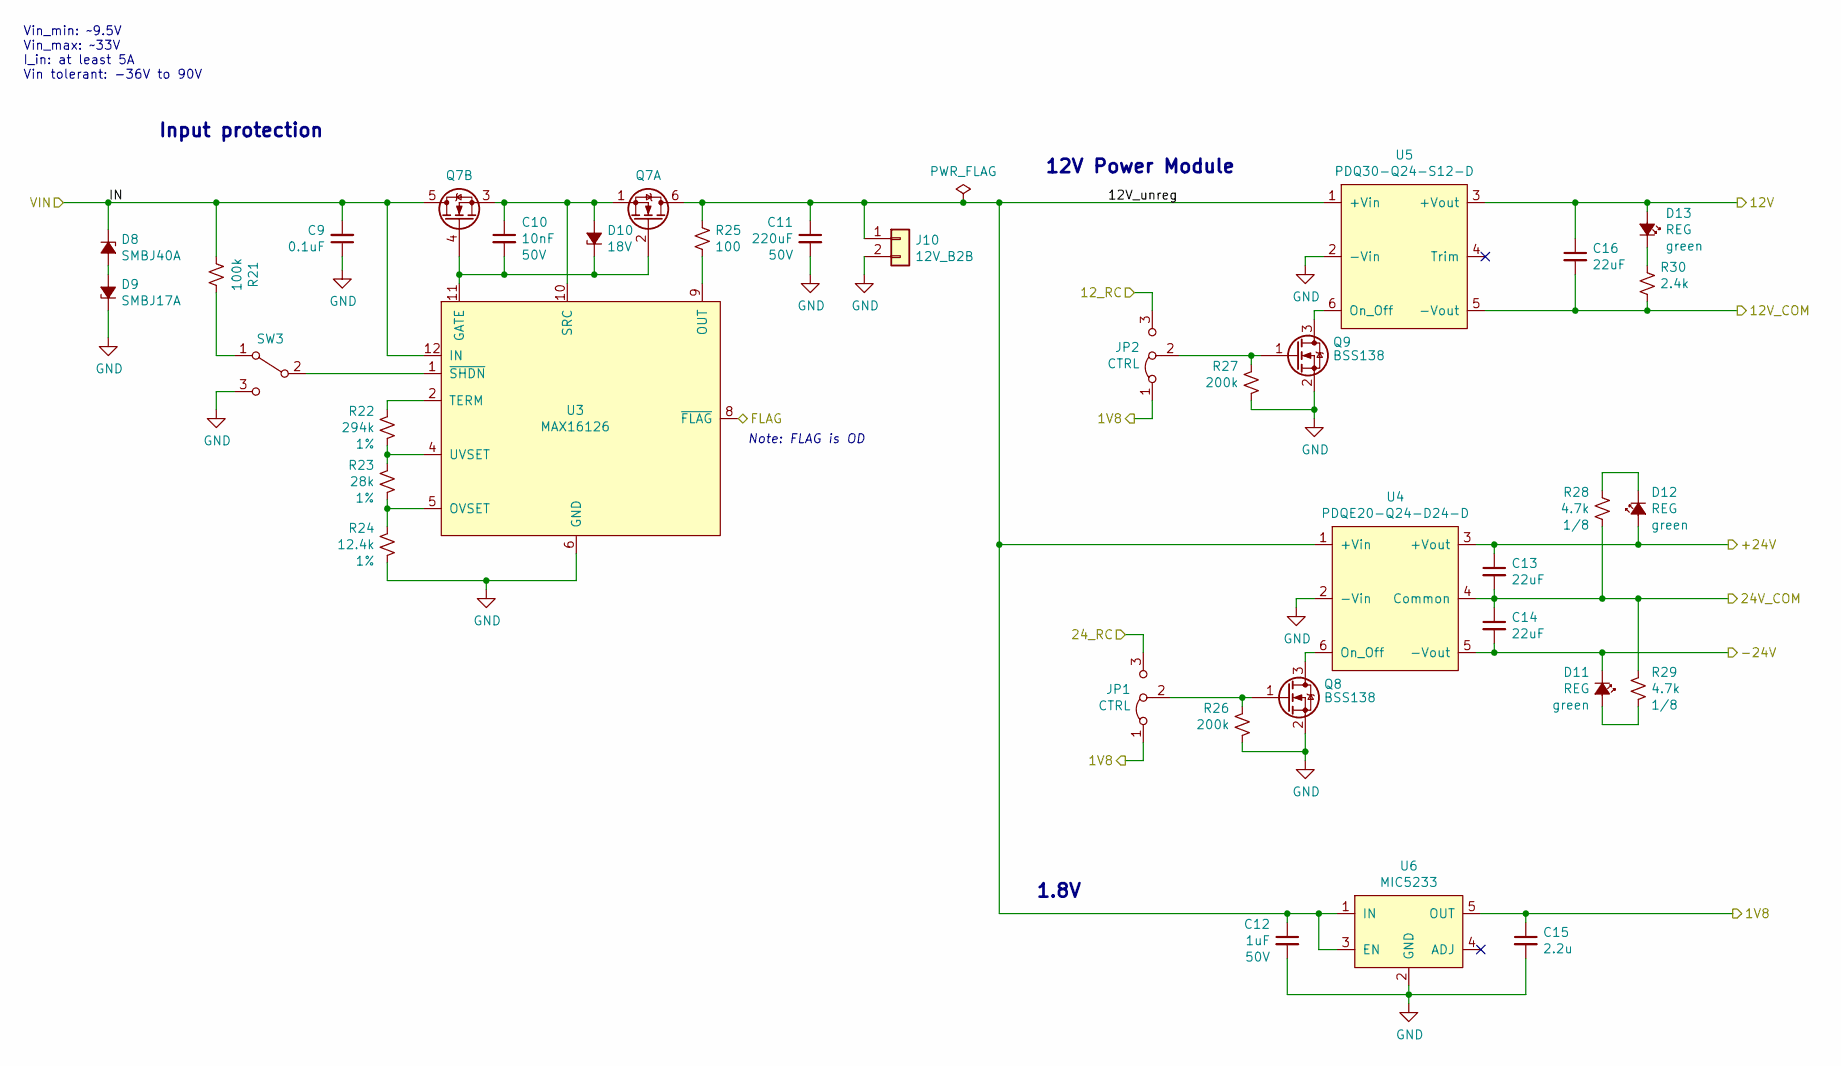
[picture p14: schematic regulators.sch]

Parts:
C9: 0.1uF; C_0603_1608Metric_Pad1.05x0.95mm_HandSolder; Voltage 50V; PartNum CL10B104KB8NNNL; DigiKey 1276-CL10B104KB8NNNLCT-ND
C10: 10nF; C_0603_1608Metric_Pad1.05x0.95mm_HandSolder; Voltage 50V; PartNum CL10B103KB8NNNC; DigiKey 1276-1009-1-ND
C11: 220uF; CP_Radial_D10.0mm_P5.00mm; Voltage 50V; PartNum EEU-FM1H221; DigiKey P12397-ND
C12: 1uF; C_0603_1608Metric_Pad1.05x0.95mm_HandSolder; Voltage 50V; PartNum CL10A105KB8NNNC; DigiKey 1276-1860-1-ND
C13, C14, C16: 22uF; C_1812_4532Metric_Pad1.30x3.40mm_HandSolder; PartNum C4532X7R1E226M250KC; DigiKey 445-1607-1-ND
C15: 2.2u; C_0603_1608Metric_Pad1.05x0.95mm_HandSolder; PartNum CL10B225KQ8NFNC; DigiKey 1276-2017-1-ND
D8: SMBJ40A; D_SMB; PartNum SMBJ40A-E3/52; DigiKey SMBJ40A-E3/52GICT-ND
D9: SMBJ17A; D_SMB; PartNum SMBJ17A-E3/52; DigiKey SMBJ17A-E3/52GICT-ND
D10: 18V; D_SOD-123; PartNum BZT52B18; DigiKey BZT52B18RHGCT-ND
D11, D12, D13: REG; LED_0805_2012Metric_Pad1.15x1.40mm_HandSolder; PartNum 150080GS75000; DigiKey 732-4983-1-ND
J10: 12V_B2B; PinHeader_1x02_P2.54mm_Vertical; PartNum 22-03-2021; DigiKey WM4000-ND
JP1, JP2: CTRL; PinHeader_1x03_P2.54mm_Vertical; PartNum 61300311121; DigiKey 732-5316-ND
Q7: NVMFD5C668NL; DFN-8-2EP_5x6mm_P1.27mm_EP4.84x5.55mm; PartNum NVMFD5C668NLT1G; DigiKey NVMFD5C668NLT1GOSCT-ND
Q8, Q9: BSS138; SOT-23; PartNum BSS138K; DigiKey BSS138KCT-ND
R21: 100k; R_0603_1608Metric_Pad1.05x0.95mm_HandSolder; PartNum CRGP0603F100K; DigiKey A130440CT-ND
R22: 294k; R_0603_1608Metric_Pad1.05x0.95mm_HandSolder; PartNum RC0603FR-07294KL; DigiKey 311-294KHRCT-ND
R23: 28k; R_0603_1608Metric_Pad1.05x0.95mm_HandSolder; PartNum RC0603FR-0728KL; DigiKey 311-28.0KHRCT-ND
R24: 12.4k; R_0603_1608Metric_Pad1.05x0.95mm_HandSolder; PartNum RC0603FR-0712K4L; DigiKey 311-12.4KHRCT-ND
R25: 100; R_0603_1608Metric_Pad1.05x0.95mm_HandSolder; PartNum CRGP0603F100R; DigiKey A130404CT-ND
R26, R27: 200k; R_0603_1608Metric_Pad1.05x0.95mm_HandSolder; PartNum SDR03EZPF2003; DigiKey 511-1705-1-ND
R28, R29: 4.7k; R_0603_1608Metric_Pad1.05x0.95mm_HandSolder; PartNum SDR03EZPF2401; DigiKey 511-1710-1-ND
R30: 2.4k; R_0603_1608Metric_Pad1.05x0.95mm_HandSolder; PartNum RC0805FR-072K4L; DigiKey 311-2.40KCRCT-ND
SW3: ON/OFF; ATE1D-2M3-10-Z; PartNum ATE1D-2M3-10-Z; DigiKey 563-1157-ND
U3: MAX16126; TQFN-12-EP_3x3mm_P0.5mm_EP1.23x1.23mm; PartNum MAX16126TCA+T; DigiKey MAX16126TCA+TCT-ND
U4: PDQE20-Q24-D24-D; 1x1_DC_DC_MODULE; PartNum PDQE20-Q24-D24-D; DigiKey 102-6353-ND
U5: PDQ30-Q24-S12-D; 1x1_DC_DC_MODULE; PartNum PDQ30-Q24-S12-D; DigiKey 102-3892-ND
U6: MIC5233; SOT-23-5_HandSoldering; PartNum MIC5233-1.8YM5-TR; DigiKey 576-2775-1-ND

Connections:
+1V8: C15.1, JP1.1 (A), JP2.1 (A), U6.5 (OUT); also elsewhere on the board
+12V: C16.1, D13.2 (A), U5.3 (+Vout); also elsewhere on the board
/12_RC: JP2.3 (B); also elsewhere on the board
/24V_COM: C13.2, C14.1, R28.1, R29.1, U4.4 (Common); also elsewhere on the board
/24_RC: JP1.3 (B); also elsewhere on the board
/+24V: C13.1, D12.2 (A), U4.3 (+Vout); also elsewhere on the board
/-24V: C14.2, D11.1 (K), U4.5 (-Vout); also elsewhere on the board
/FLAG: U3.8 (~FLAG); also elsewhere on the board
/Regulators (R)/12V_unreg: C11.1, C12.1, J10.1, Q7.6 (S), R25.1, U4.1 (+Vin), U5.1 (+Vin), U6.1 (IN), U6.3 (EN)
/VIN: C9.2, D8.1 (K), Q7.5 (D), R21.2, U3.12 (IN); also elsewhere on the board
GND: C9.1, C11.2, C12.2, C15.2, C16.2, D9.1 (K), J10.2, Q8.2 (S), Q9.2 (S), R24.1, R26.1, R27.1, R30.1, SW3.3 (C), U3.6 (GND), U3.7 (GND), U3.EP (GND), U4.2 (-Vin), U5.2 (-Vin), U5.5 (-Vout), U6.2 (GND); also elsewhere on the board
unnamed: C10.1, D10.2 (A), Q7.1 (S), Q7.3 (S), U3.10 (SRC)
unnamed: C10.2, D10.1 (K), Q7.2 (G), Q7.4 (G), U3.11 (GATE)
unnamed: D8.2 (A), D9.2 (A)
unnamed: D11.2 (A), R29.2
unnamed: D12.1 (K), R28.2
unnamed: D13.1 (K), R30.2
unnamed: JP1.2 (C), Q8.1 (G), R26.2
unnamed: JP2.2 (C), Q9.1 (G), R27.2
unnamed: Q8.3 (D), U4.6 (On_Off)
unnamed: Q9.3 (D), U5.6 (On_Off)
unnamed: R21.1, SW3.1 (A)
unnamed: R22.1, R23.2, U3.4 (UVSET)
unnamed: R22.2, U3.2 (TERM)
unnamed: R23.1, R24.2, U3.5 (OVSET)
unnamed: R25.2, U3.9 (OUT)
unnamed: SW3.2 (B), U3.1 (~SHDN)

Notes on the sheet:
1.8V
Input protection
12V Power Module
Vin_min: ~~9.5V Vin_max: ~~33V I_in: at least 5A Vin tolerant: -36V to 90V
Note: FLAG is OD

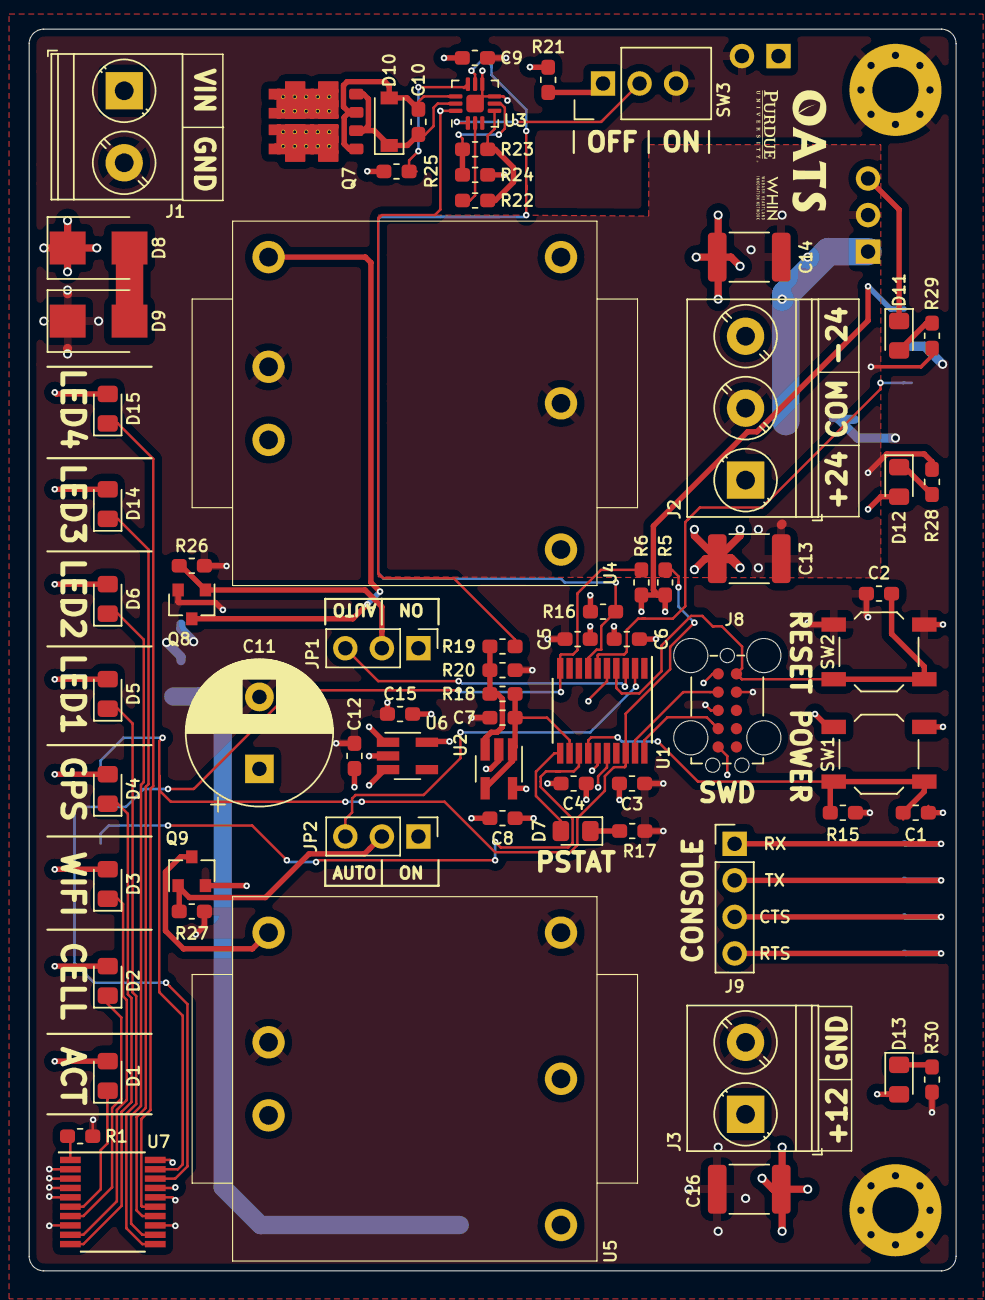
[picture p15: board udoo-power.kicad_pcb from above]

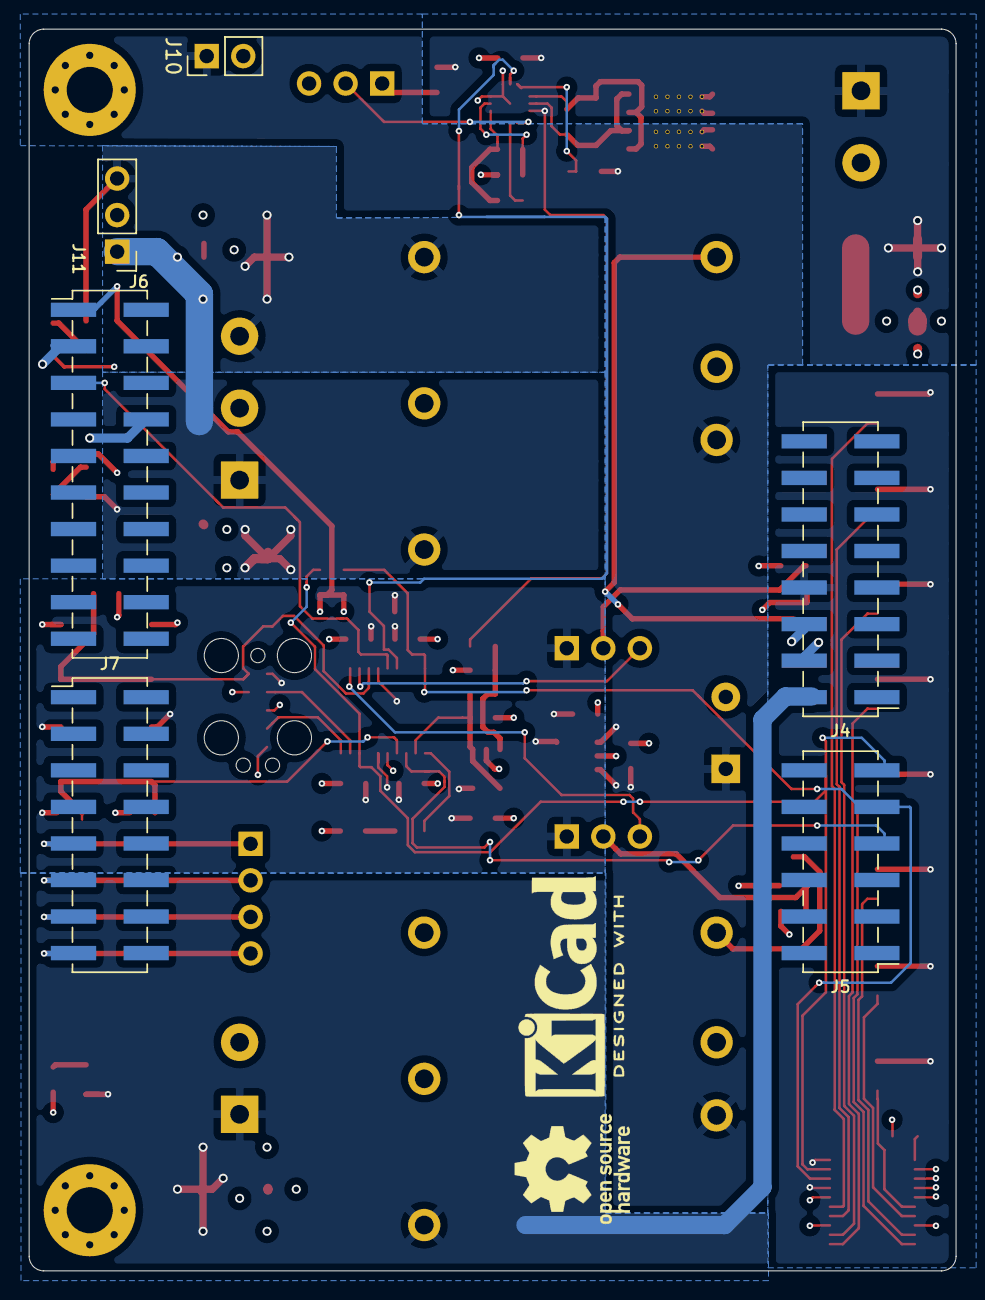
[picture p16: board udoo-power.kicad_pcb from below]

Board: 4 copper layers, 64.4 x 86.3 mm, 83 parts (8 on the bottom side), 54 nets.
